brightcolorfulflickers/holmeswatsoncameo/code/cameo_u8glib.ino

/*
 * Holmes <3 Watson Cameo Necklace
 * by brightcolorfulflickers
 * June 2016
 *
 * github.com/brightcolorfulflickers
 * brightcolorfulflickers.tumblr.com
 * instagram.com/brightcolorfulflickers
 */

#include "U8glib.h"

// Place your initialization settings here! Replace/delete whatever you need.

U8GLIB_SH1106_128X64 u8g(U8G_I2C_OPT_NONE);  // I2C / TWI 
//U8GLIB_SSD1306_128X64 u8g(U8G_I2C_OPT_NONE|U8G_I2C_OPT_DEV_0);  // I2C / TWI 
#define MOSI_PIN 9
#define CS_PIN 12
#define SCK_PIN 10
#define DC_PIN 9
//U8GLIB_SSD1306_128X64 u8g(SCK_PIN, MOSI_PIN, CS_PIN, DC_PIN);  // SW SPI Com: SCK = 13, MOSI = 11, CS = 10, A0 = 9

// End initialization section.

#define watsonheadtry3_width 68
#define watsonheadtry3_height 64
static const unsigned char watsonheadtry3_bits[] PROGMEM = {
   0x00, 0x00, 0x00, 0x00, 0x00, 0xf0, 0xff, 0xff, 0x0f, 0x00, 0x00, 0x00,
   0x00, 0x00, 0xf0, 0xff, 0xff, 0x0f, 0x00, 0x00, 0x00, 0x00, 0x00, 0xf8,
   0xff, 0xff, 0x0f, 0x00, 0x00, 0x00, 0x00, 0x00, 0xfc, 0xff, 0xff, 0x0f,
   0x00, 0x00, 0x00, 0x00, 0x00, 0xfe, 0xff, 0xff, 0x0f, 0x00, 0x00, 0x00,
   0x00, 0x00, 0xff, 0xff, 0xff, 0x0f, 0x00, 0x00, 0x00, 0x00, 0x80, 0xff,
   0xff, 0xff, 0x0f, 0x00, 0x00, 0x00, 0x00, 0xc0, 0xff, 0xff, 0xff, 0x0f,
   0x00, 0x00, 0x00, 0x00, 0x80, 0xff, 0xff, 0xff, 0x0f, 0x00, 0x00, 0xc0,
   0x01, 0x80, 0xff, 0xff, 0xff, 0x0f, 0x00, 0x00, 0xf8, 0x7f, 0x80, 0xff,
   0xff, 0xff, 0x0f, 0x00, 0x80, 0xff, 0xff, 0x3f, 0xff, 0xff, 0xff, 0x0f,
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
   0xf8, 0xd1, 0x3b, 0xce, 0xff, 0xff, 0xff, 0xff, 0x18, 0xff, 0x7d, 0xce,
   0xff, 0xff, 0xff, 0x71, 0x98, 0xff, 0xfd, 0xcc, 0xff, 0xff, 0xdf, 0x21,
   0x0c, 0xfe, 0xbd, 0xcd, 0xff, 0xff, 0xbf, 0x39, 0x0c, 0xfd, 0x99, 0xc9,
   0xff, 0xff, 0xf7, 0x19, 0xfe, 0xfe, 0x83, 0xc3, 0xff, 0xff, 0x0b, 0x0f,
   0xbe, 0xff, 0xc3, 0xc7, 0xff, 0xff, 0x0d, 0x02, 0xe2, 0xff, 0xff, 0xff,
   0xff, 0xff, 0x0a, 0x03, 0x46, 0xff, 0xff, 0xff, 0xff, 0x7f, 0x9f, 0x01,
   0x63, 0xff, 0xcf, 0xc7, 0xff, 0xff, 0xf1, 0x00, 0xf2, 0xff, 0x03, 0xcf,
   0xff, 0xdf, 0x30, 0x00, 0xde, 0xff, 0x13, 0xce, 0xff, 0xbf, 0x31, 0x00,
   0x76, 0xff, 0x7d, 0xce, 0xff, 0xff, 0x19, 0x00, 0x42, 0xff, 0xfd, 0xcc,
   0xff, 0x0d, 0x0f, 0x00, 0x46, 0xff, 0xbd, 0xcd, 0xff, 0x0a, 0x07, 0x00,
   0xe2, 0xff, 0xb9, 0xc9, 0x7f, 0x09, 0x03, 0x00, 0x96, 0xfe, 0x83, 0xc3,
   0xff, 0xdf, 0x01, 0x00, 0xfe, 0xff, 0xc3, 0xc7, 0x7f, 0xf0, 0x00, 0x00,
   0x0c, 0xff, 0xff, 0xff, 0x57, 0x10, 0x00, 0x00, 0x0c, 0xfb, 0xff, 0xff,
   0x7d, 0x1c, 0x00, 0x00, 0x98, 0xf5, 0xff, 0x7f, 0xc7, 0x0c, 0x00, 0x00,
   0x98, 0xef, 0xff, 0xbf, 0x87, 0x07, 0x00, 0x00, 0xf0, 0x78, 0xff, 0xe7,
   0x85, 0x02, 0x00, 0x00, 0x60, 0x98, 0x71, 0x36, 0x67, 0x00, 0x00, 0x00,
   0xc0, 0x38, 0xff, 0x2d, 0x3c, 0x00, 0x00, 0x00, 0x80, 0x19, 0xaf, 0x39,
   0x1c, 0x00, 0x00, 0x00, 0x00, 0x0f, 0xc7, 0x30, 0x07, 0x00, 0x00, 0x00,
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
 

void drawNothing() {
  
}

void u8g_prepare(void) {
  u8g.setFont(u8g_font_6x10);
  u8g.setFontRefHeightExtendedText();
  u8g.setDefaultForegroundColor();
  u8g.setFontPosTop();
}

void drawSplash(void) {
  u8g_prepare();
  // graphic commands to redraw the complete screen should be placed here  
  //u8g.setFont(u8g_font_unifont);
  //u8g.setFont(u8g_font_osb21);
  u8g.drawStr( 40, 15, "Holmes <3");
  u8g.drawStr( 50, 25, "Watson");
  u8g.setFont(u8g_font_5x7);
  u8g.drawStr( 13, 42, "by pursuitofnerdiness");
}

void setup() {
  // put your setup code here, to run once:
  u8g.firstPage();
  do {  
    drawSplash();    
  } while( u8g.nextPage() );
  delay(2000); 
}

void drawHolmes(void) {
  // graphic commands to redraw the complete screen should be placed here  
  //u8g.drawBitmapP( 0, 0, 1, 8, rook_bitmap);
  u8g.drawXBMP( 30, 0, holmes_width, holmes_height, holmes_bits);
}

void drawHeart(void) {
  // graphic commands to redraw the complete screen should be placed here  
  //u8g.drawBitmapP( 0, 0, 1, 8, rook_bitmap);
  u8g.drawXBMP( 32, 0, heart221b_width, heart221b_height, heart221b_bits);
}

void drawWatson(void) {
  // graphic commands to redraw the complete screen should be placed here  
  //u8g.drawBitmapP( 0, 0, 1, 8, rook_bitmap);
  u8g.drawXBMP( 32, 0, watsonheadtry3_width, watsonheadtry3_height, watsonheadtry3_bits);
}


void loop(void) {
  // picture loop
  u8g.firstPage();  
  do {
    drawHolmes();
  } while( u8g.nextPage() );
  
  // rebuild the picture after some delay
  delay(5000);

  // picture loop
  u8g.firstPage();  
  do {
    drawHeart();
  } while( u8g.nextPage() );
  
  // rebuild the picture after some delay
  delay(5000);

 
  // picture loop
  u8g.firstPage();  
  do {
    drawWatson();
  } while( u8g.nextPage() );
  
  // rebuild the picture after some delay
  delay(5000);

    // picture loop
  u8g.firstPage();  
  do {
    drawHeart();
  } while( u8g.nextPage() );
  
  // rebuild the picture after some delay
  delay(5000);
}
